AnttiLukats/DIPSY/THP2015/hw/DIPSY/readme.txt

\pcb - current last revision

\REV01\ original DIPSY easyPCB design
