AnttiLukats/DIPSY/THP2015/examples/verilog/spi_peripherals/readme.txt

place all verilog based project that works as SPI Slave here
