AnttiLukats/DIPSY/THP2015/hw/EDA/eagle/readme.txt

dipsy.lbr
- is not really tested yet
- dipsy footprint with all connections
- dipsy BB (breadboard) footprint with outer pins only
