AnttiLukats/DIPSY/THP2015/examples/verilog/ws2812b_standalone/ws2812b_single_fixed/README.md

## WS2812B standalone, single pixel, fixed color
Demonstrates the WS2812B driver. The code sends pulses for a single pixel/LED, with color fixed white at 25% (0x404040).
