AnttiLukats/DIPSY/docs/index.rst

DIPSY
=====

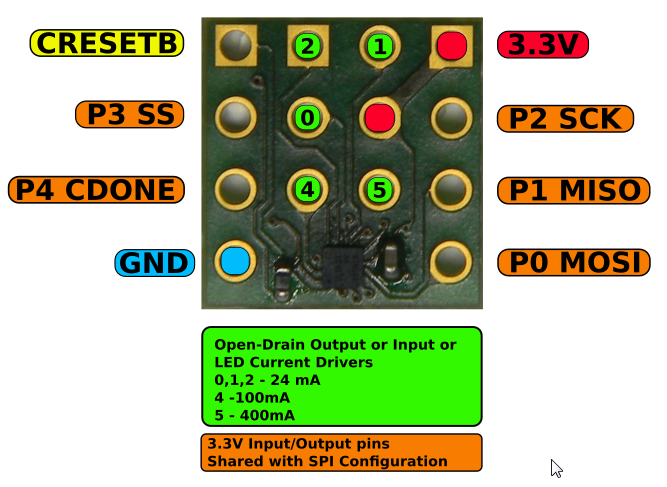
[picture p1: docs/dipsy-pinout.png]
