AnttiLukats/DIPSY/THP2015/hw/DIPSY/pcb/manufacturing reports/ExportSTEP/DIPSY-02.step

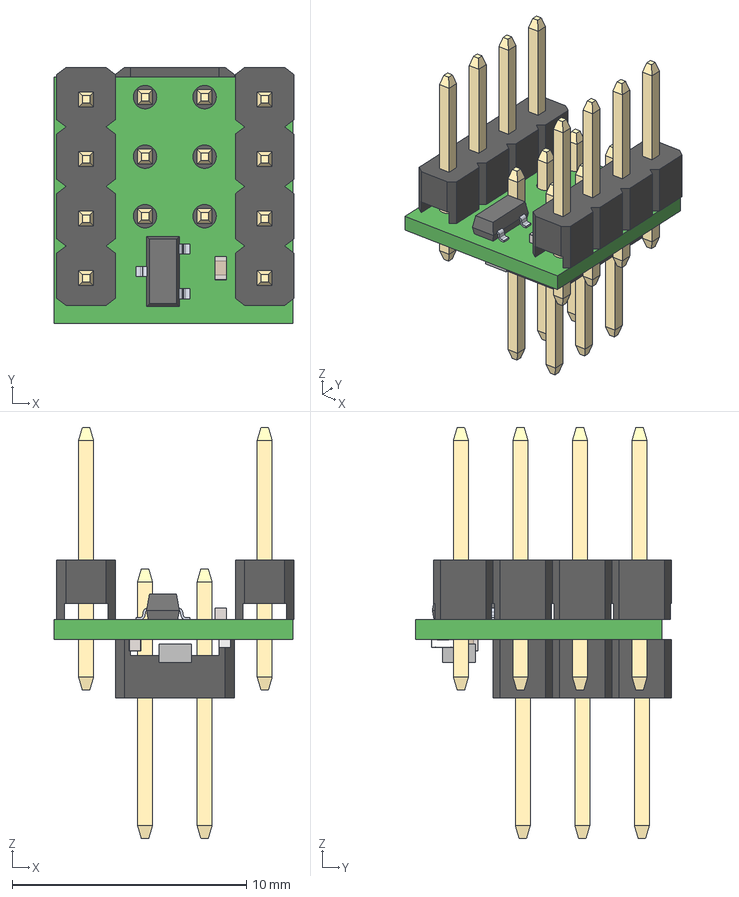
[picture p2: CAD file, 2015-09-20]
THP2015/hw/DIPSY/pcb/manufacturing reports/ExportSTEP/DIPSY-02.step
10.2 x 10.9 x 17.5 mm
Board
pin_header_awl254-dg-g06d
Extruded
pin_header_aw140-eg-g04d x 2
User_Library-SMD_CAPACITOR0402 x 2
RESC1005X04N
SOT-23_Plastic_surface-mounted_package;_3_leads;_3.0x2.5_mm
