AnttiLukats/DIPSY/(list of files, cad)

Other CAD files:
THP2015/hw/DIPSY/REV01/manufacturing reports/ExportSTEP/DIPSY-01.step
