AnttiLukats/DIPSY/THP2015/hw/EDA/CircuitMaker/readme.txt

Repo for CiruitMaker related files and infos

Note: Circuit maker stores the projects in cloud and not locally so here only some export file an links can be stored
