AnttiLukats/DIPSY/THP2015/DIPSY-GUIDE/graphics/svg/readme.txt

Please use free InkScape to modify the SVG Graphics
