AnttiLukats/DIPSY/THP2015/DIPSY-GUIDE/graphics/images/DIPSY_PCB_TOP.JPG

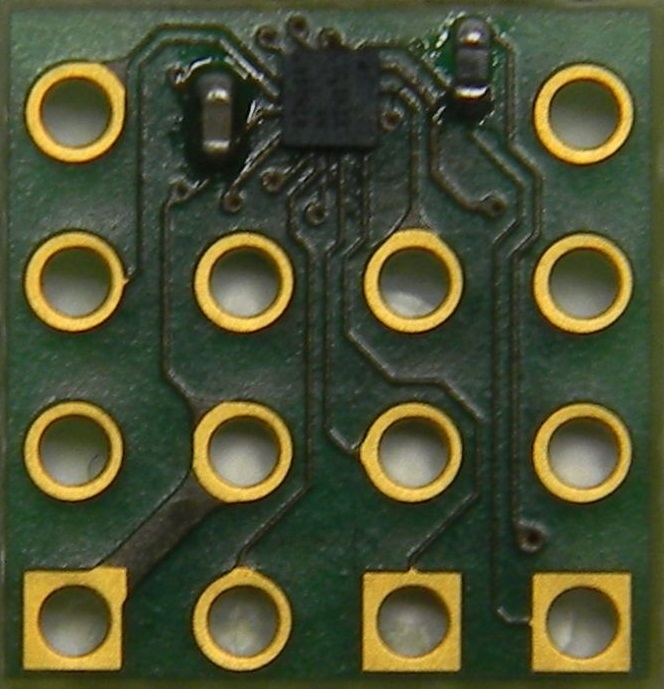
THP2015/DIPSY-GUIDE/graphics/images/DIPSY_PCB_TOP.JPG
