AnttiLukats/DIPSY/(threads)

Thread 2 (2015-08-28):

Possible application: SPI or I2C -> dipsy -> Shift registers -> Servos

crteensy, 2015-08-28:
Use a dipsy to generate PPM signals, feed them into shift registers and drive servos:

I2C: 2 I/O, SPI: 3 I/O (I2C is probably cool because the data rate for servos is low)
- 8 servos per reg
- one shared "data" pin for all registers
- one clock for each shift register
- leaves us with (10-2-1) = 7 clock outputs = 56 servos with I2C
or (10-3-1) = 6 clock outputs = 48 servos with SPI

Thread 3 (2015-08-28):

Possible application: monochrome -> RGB565 pixel expander

crteensy, 2015-08-28:
(this is what I actually want to do with the dipsy)

I have an application where my graphical data is monochrome, but my display has 16-bit color depth. Drawing is done on a monochrome frame buffer (128*128 pixels) in a teensy 3.1. Without any external hardware I then need to expand each pixel to 16 bits, in "chunks", and send those to the display. This wastes CPU and SPI time. Monochrome to RGB565 expansion can instead be done by a dipsy.

- MCU -> SPI -> Dipsy
- 2 kB frame buffer
- Dipsy -> SPI -> Display
- one slave select each for dipsy config (foreground color), direct display access (init and stuff like that), and framebuffer access
