AnttiLukats/DIPSY/THP2015/hw/DIPSY-EPT/pcb/manufacturing reports/PDF/SCH-TE0888-02.PDF

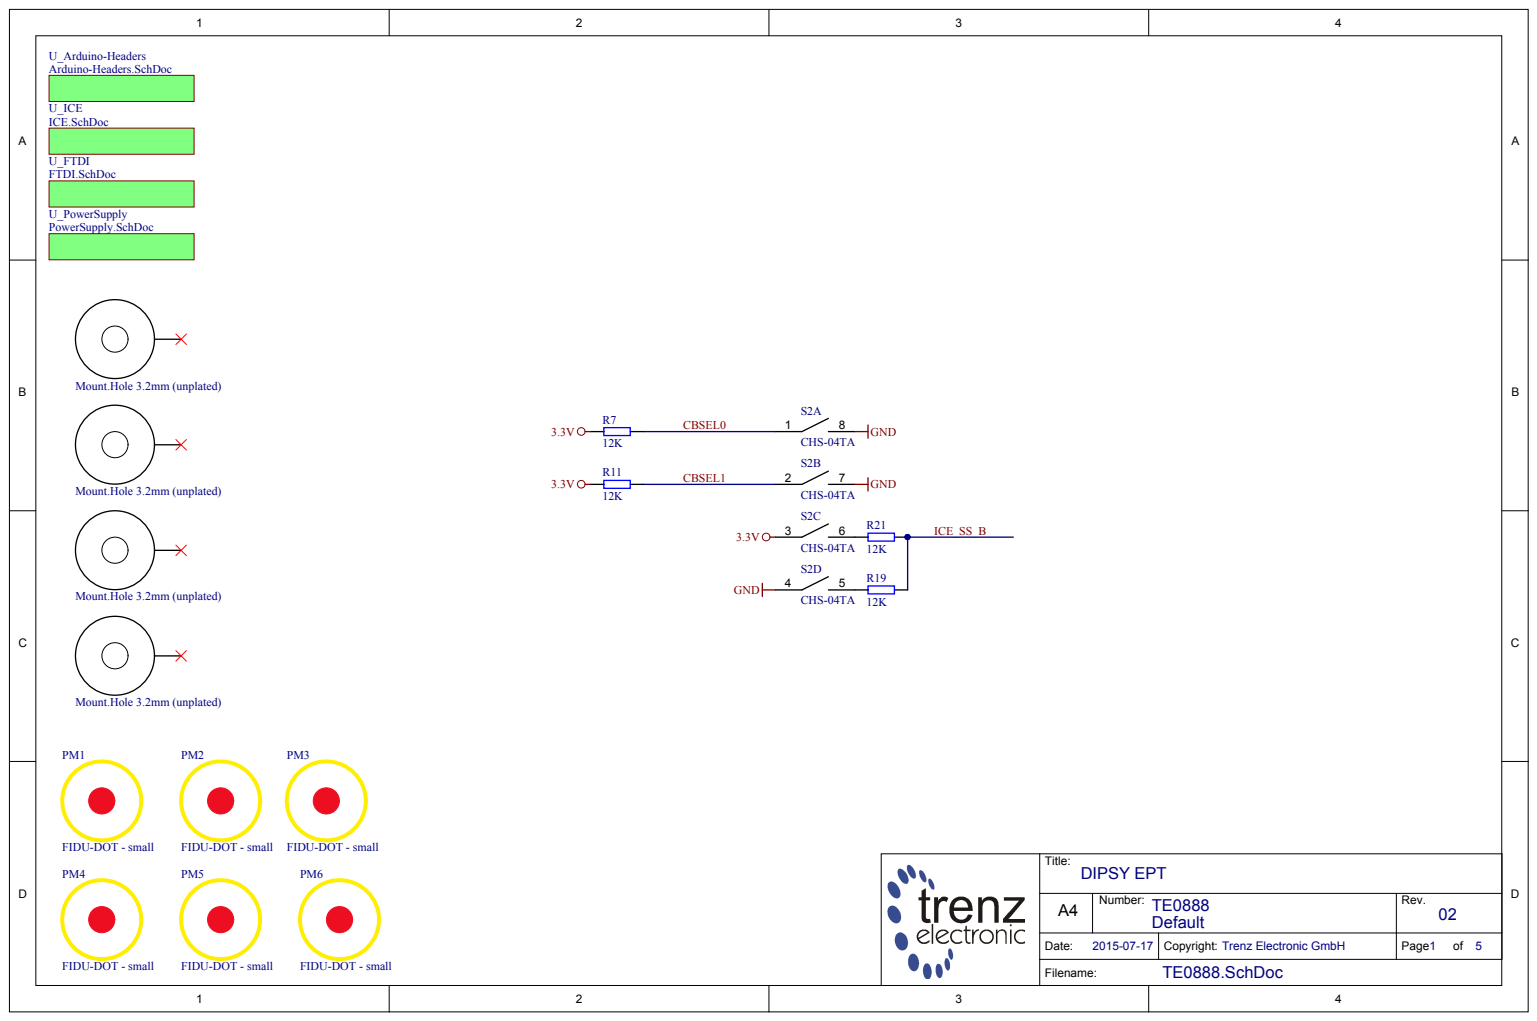
[picture p4: page 1]

Title: DIPSY EPT

A4 | Number: TE0888 Default | Rev. 02

Date: 2015-07-17 | Copyright: Trenz Electronic GmbH | Page1 of 5

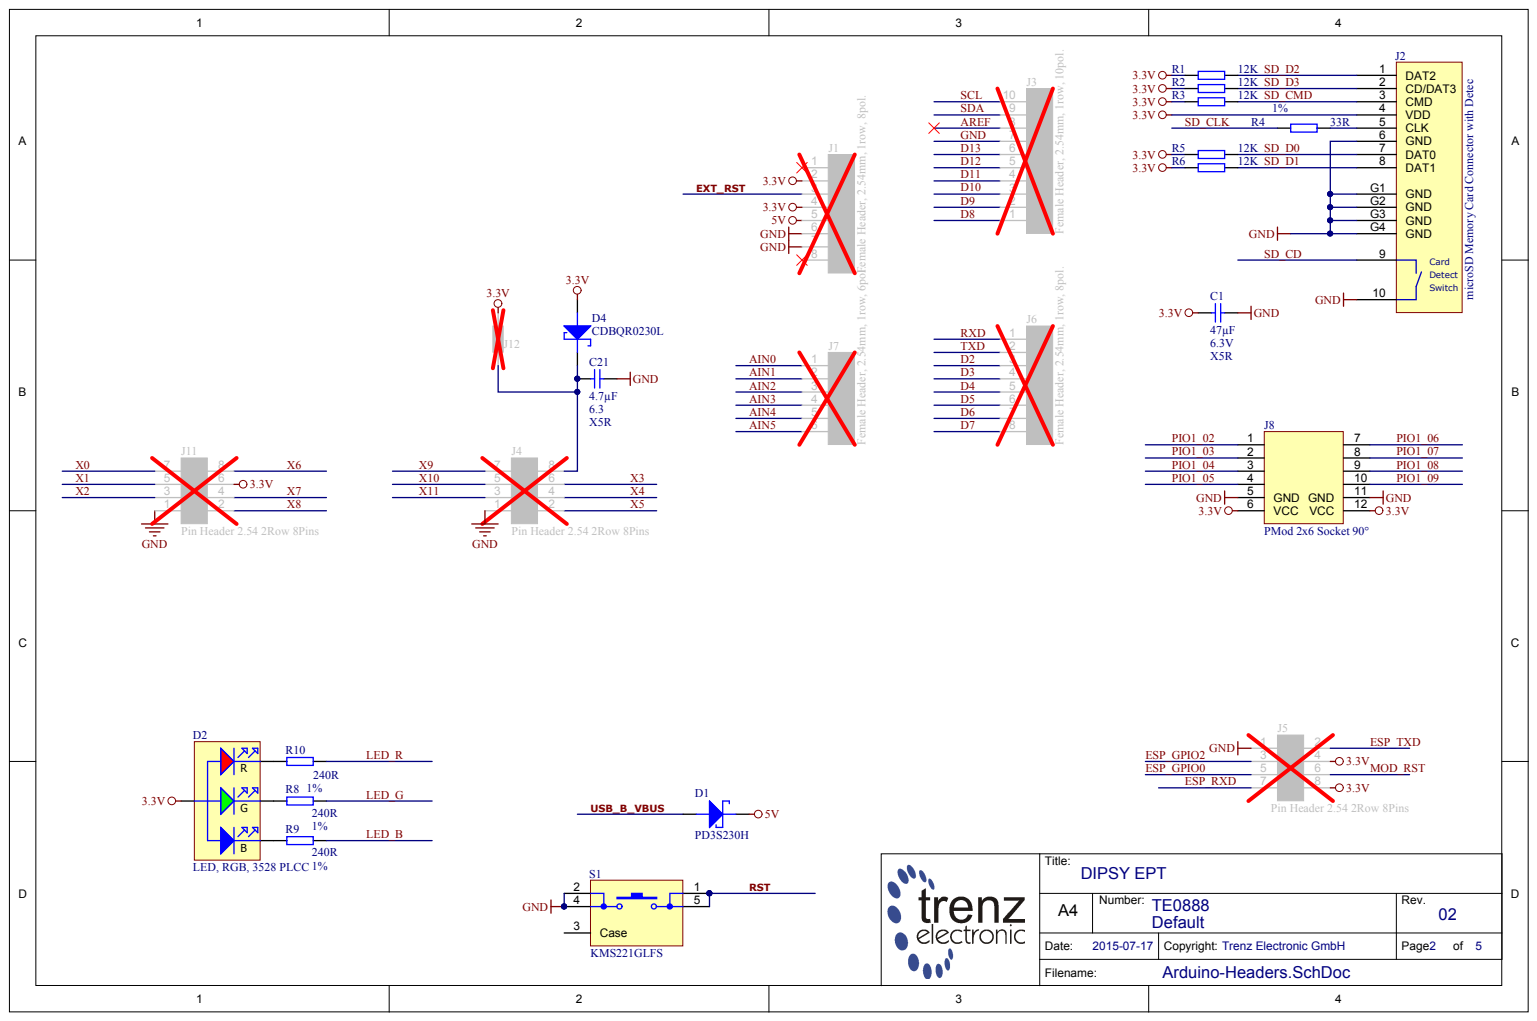
[picture p5: page 2]

microSD Memory Card Connector with Detec

DAT0 7
DAT1 8

GND G1
GND G2
GND G3

Copyright: Trenz Electronic GmbH

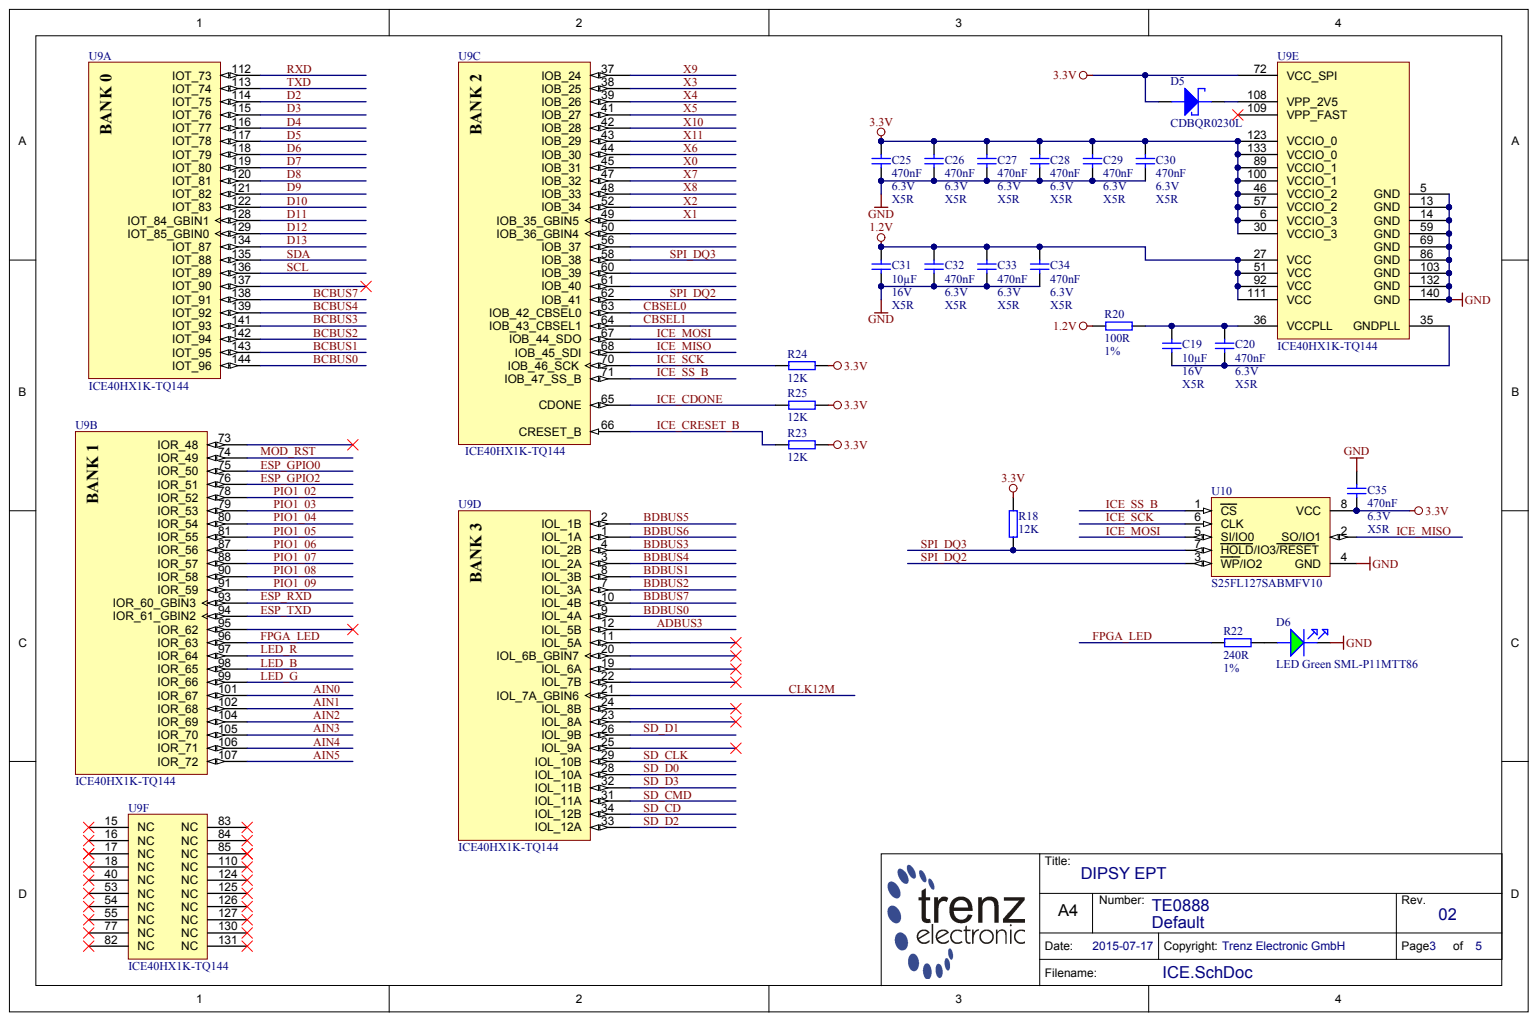
[picture p6: page 3]

Copyright: Trenz Electronic GmbH

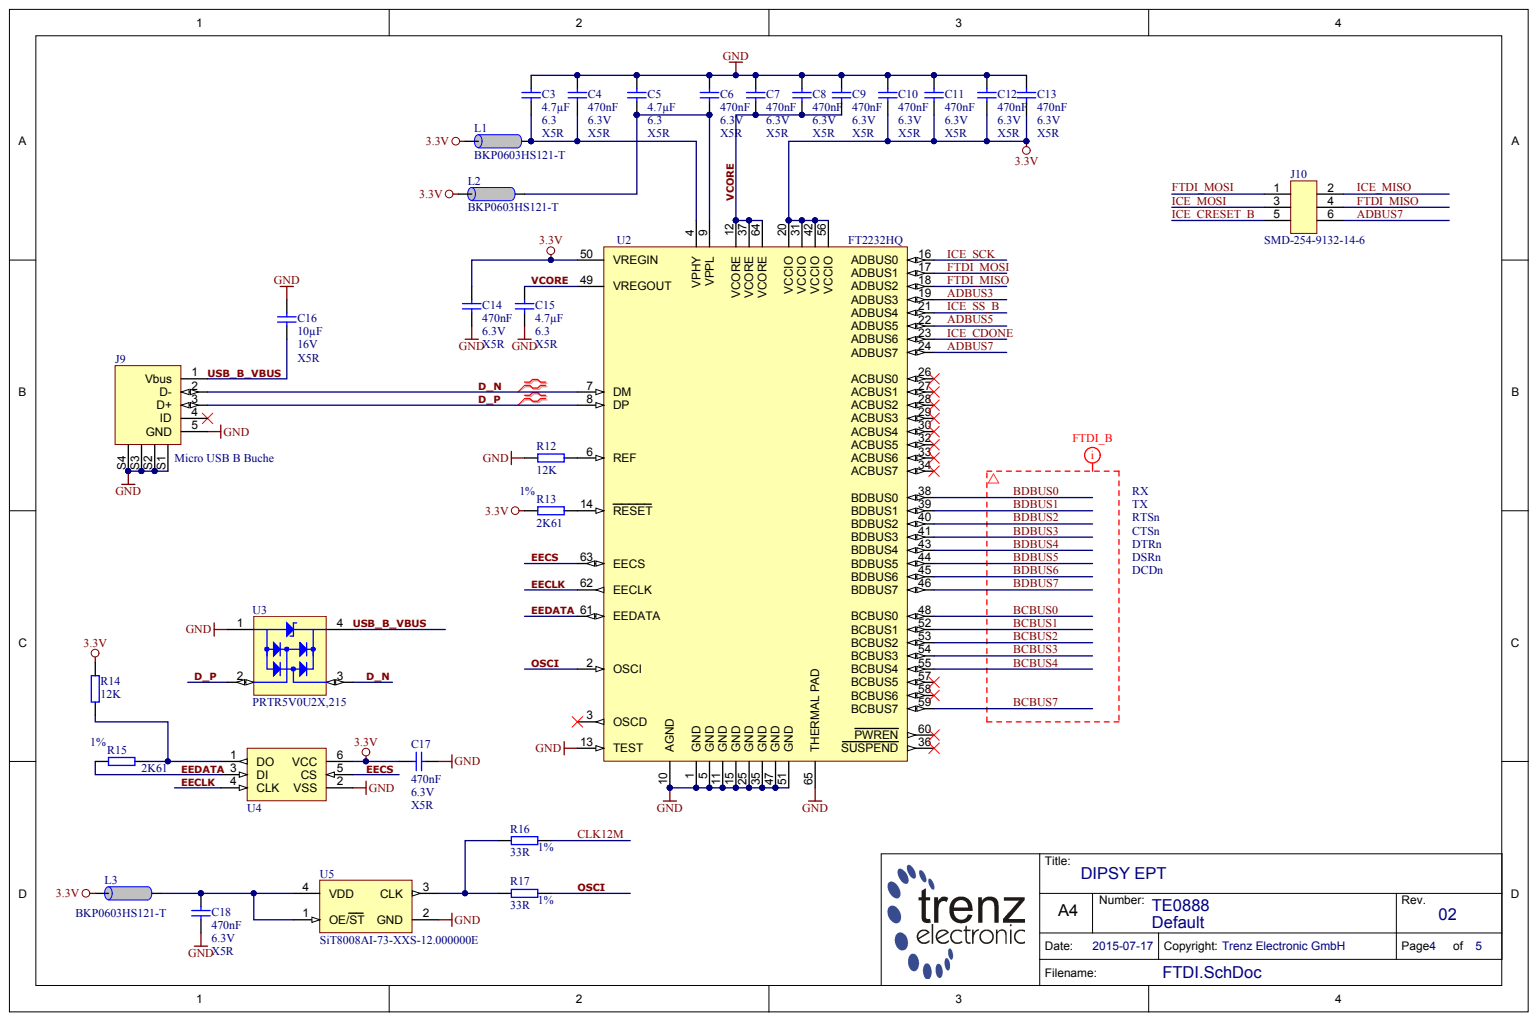
[picture p7: page 4]

REF 6

EECS 63 | BDBUS2

Title: DIPSY EPT

A4 | Number: TE0888 Default | Rev. 02

Date: 2015-07-17 | Copyright: Trenz Electronic GmbH | Page4 of 5

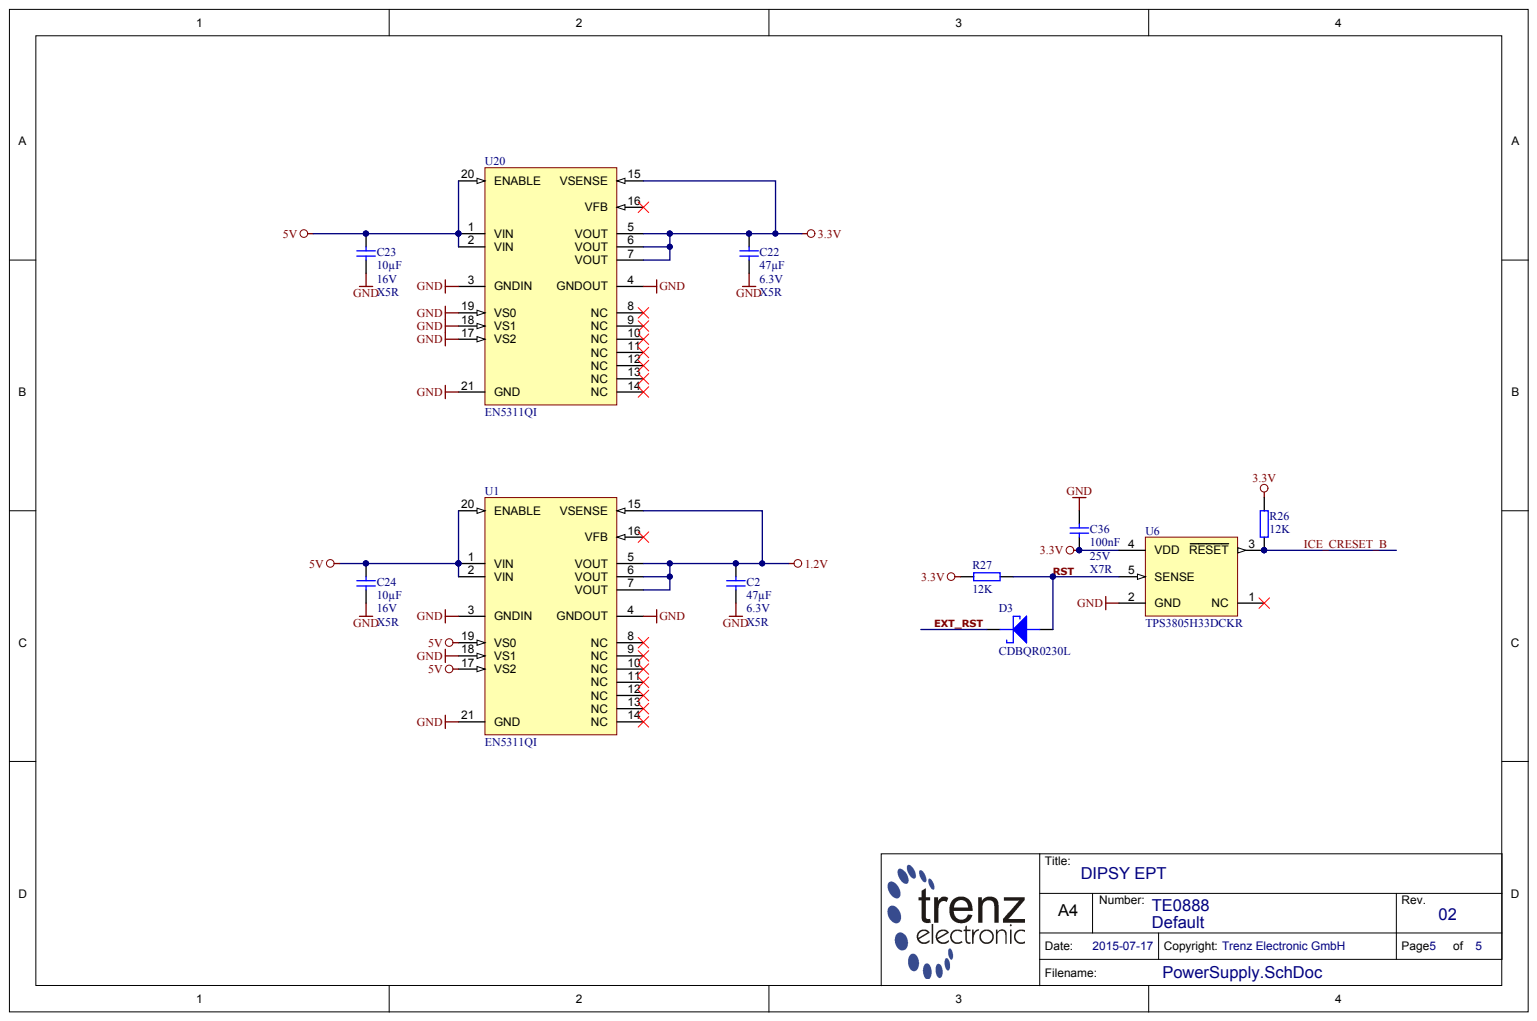
[picture p8: page 5]

Title: DIPSY EPT

A4 | Number: TE0888 Default | Rev. 02

Date: 2015-07-17 | Copyright: Trenz Electronic GmbH | Page5 of 5
