AnttiLukats/DIPSY/THP2015/hw/DIPSY/pcb/manufacturing reports/PDF/SCH-DIPSY-02.PDF

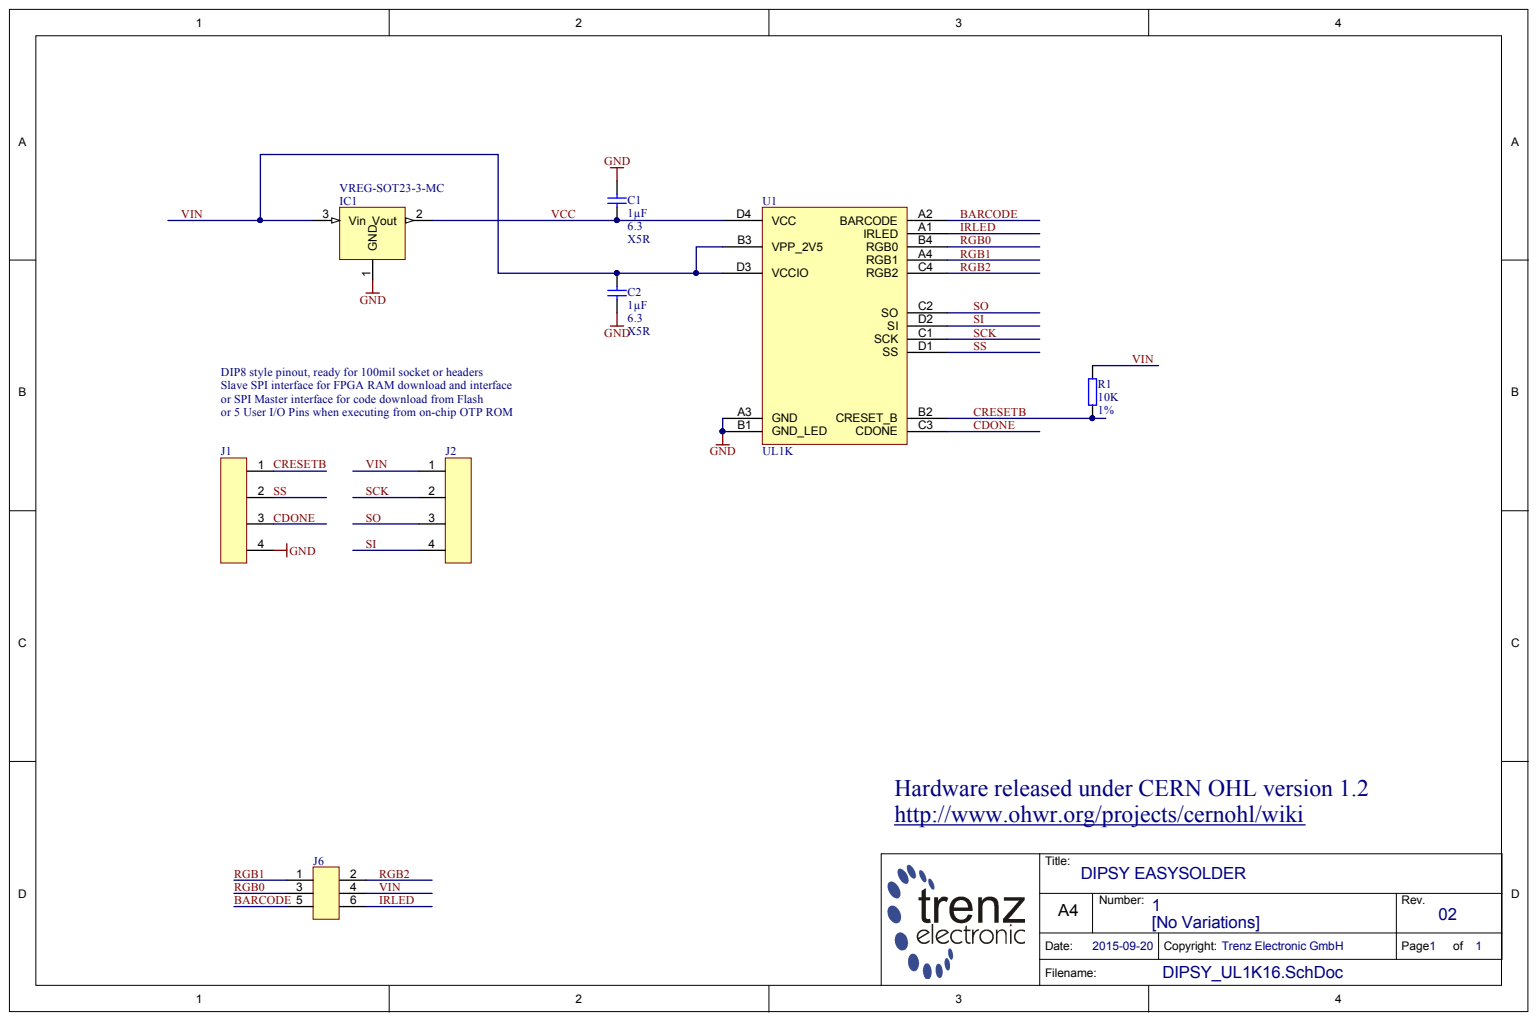
[picture p9: page 1]

6.3 X5R | VPP_2V5 B3

VCCIO D3

DIP8 style pinout, ready for 100mil socket or headers
Slave SPI interface for FPGA RAM download and interface
or SPI Master interface for code download from Flash
or 5 User I/O Pins when executing from on-chip OTP ROM

Hardware released under CERN OHL version 1.2
http://www.ohwr.org/projects/cernohl/wiki

Title: DIPSY EASYSOLDER

A4 | Number: 1 [No Variations] | Rev. 02

Date: 2015-09-20 | Copyright: Trenz Electronic GmbH | Page1 of 1
