AnttiLukats/DIPSY/THP2015/hw/DIPSY-EPT/pcb/manufacturing reports/PDF/3DB-TE0888-02.PDF

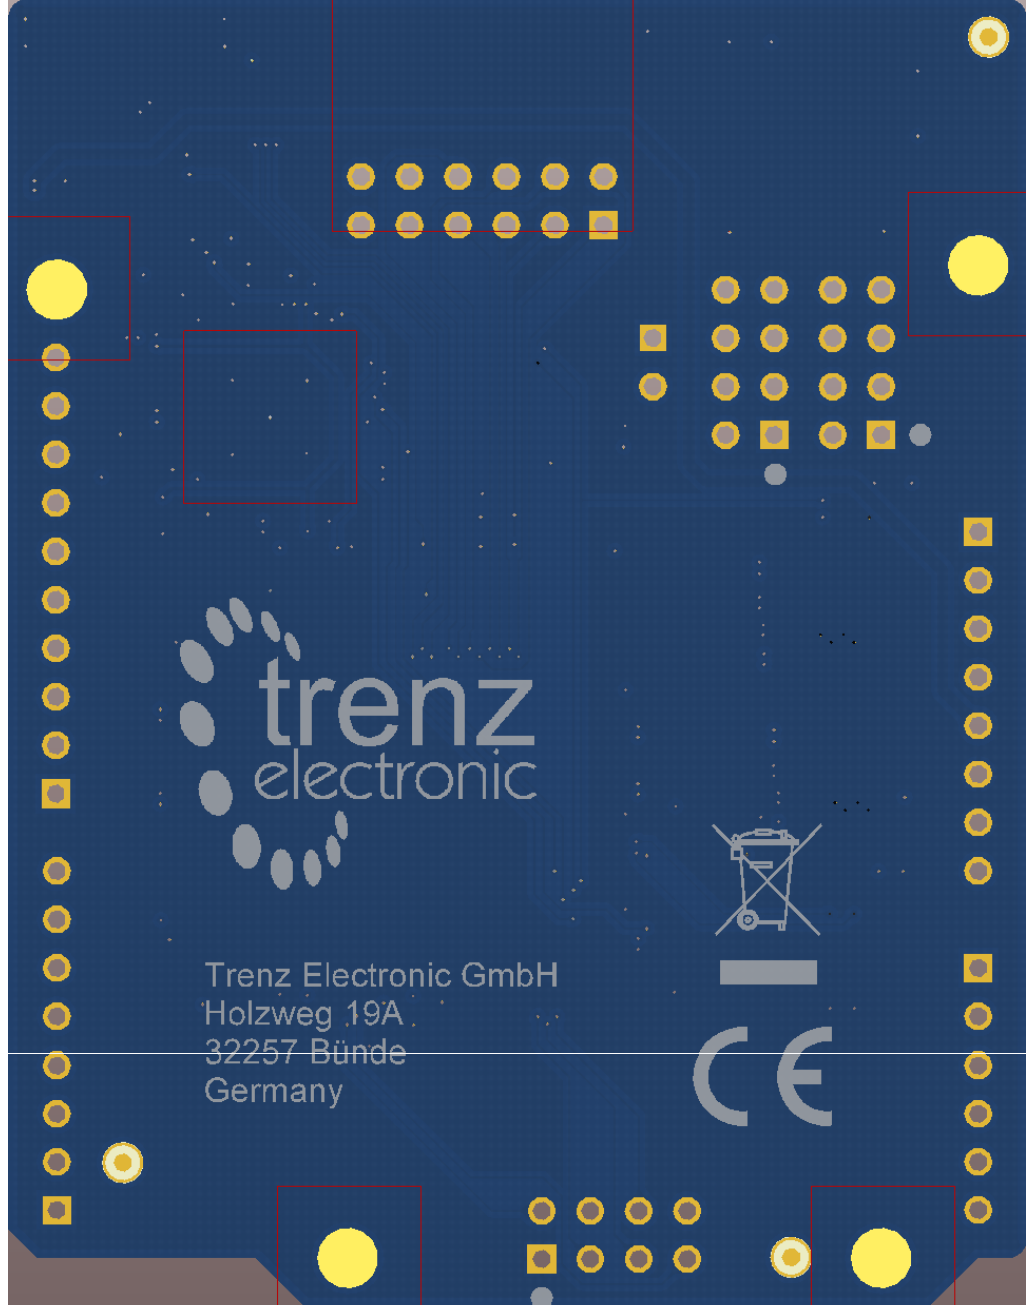
[picture p10: page 1]
