AnttiLukats/DIPSY/THP2015/hw/DIPSY-EPT/pcb/manufacturing reports/PDF/3DT-TE0888-02.PDF

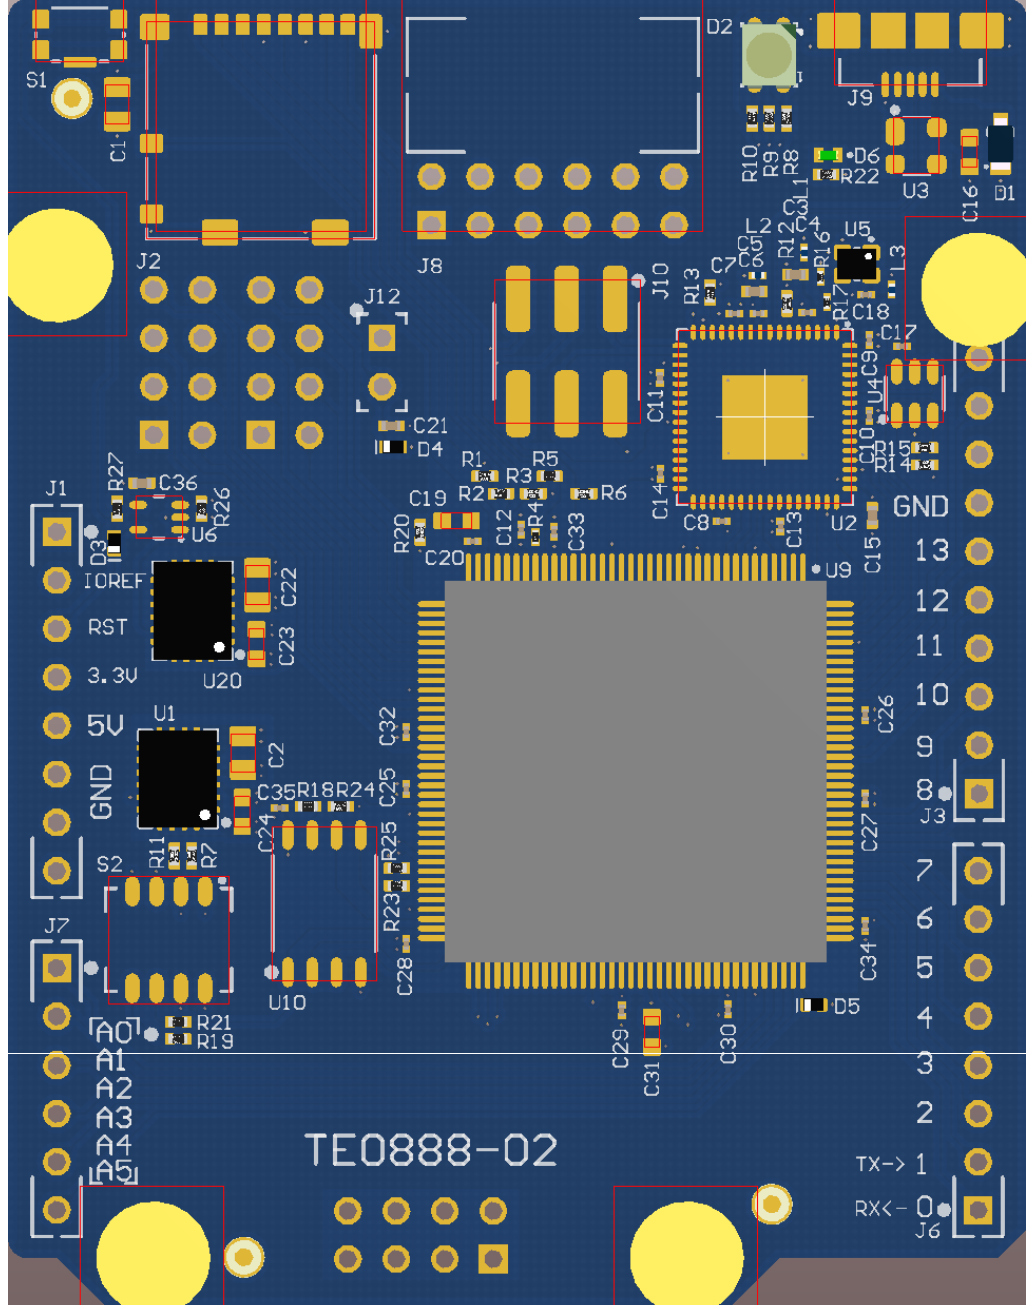
[picture p11: page 1]
