AnttiLukats/DIPSY/THP2015/hw/DIPSY-EPT/pcb/manufacturing reports/PDF/AD-TE0888-02.PDF

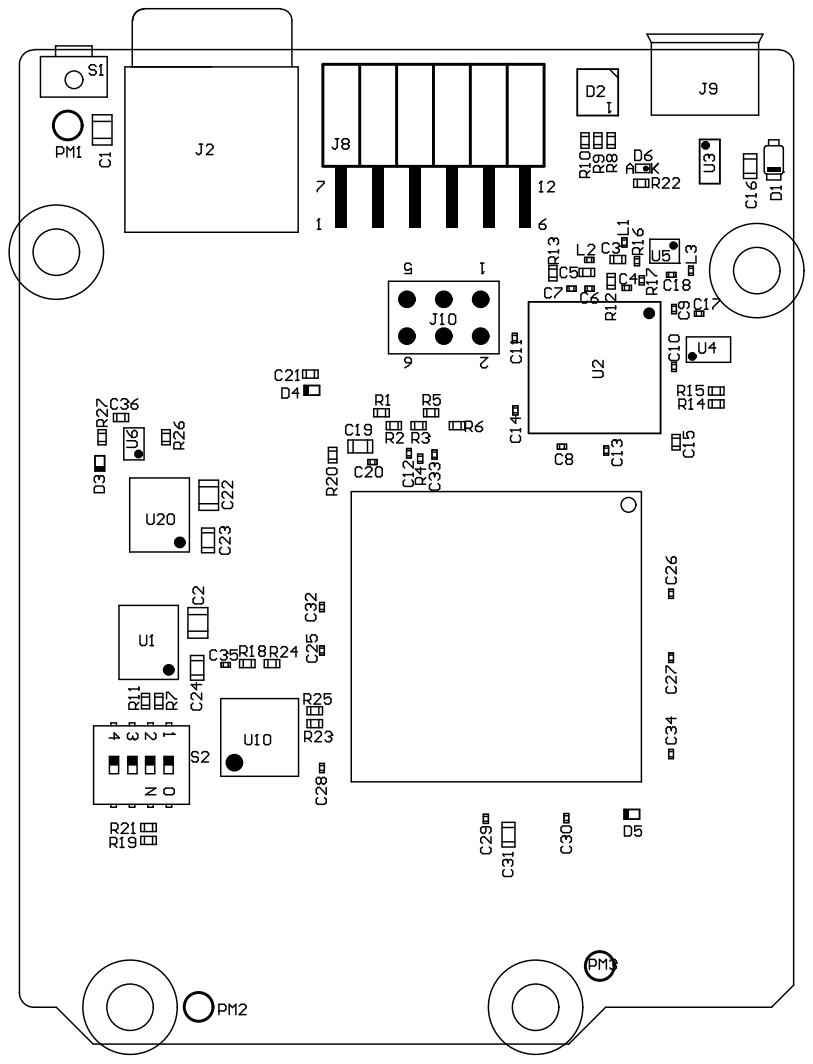
[picture p12: page 1]

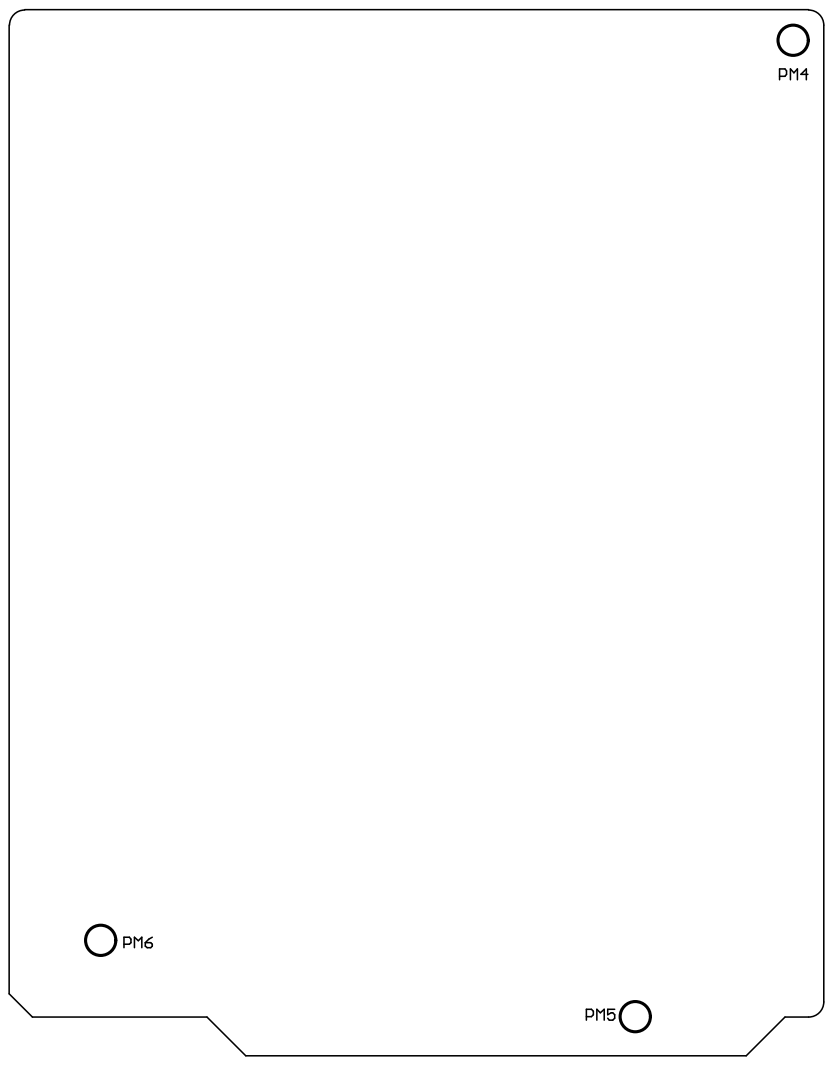
[picture p13: page 2]

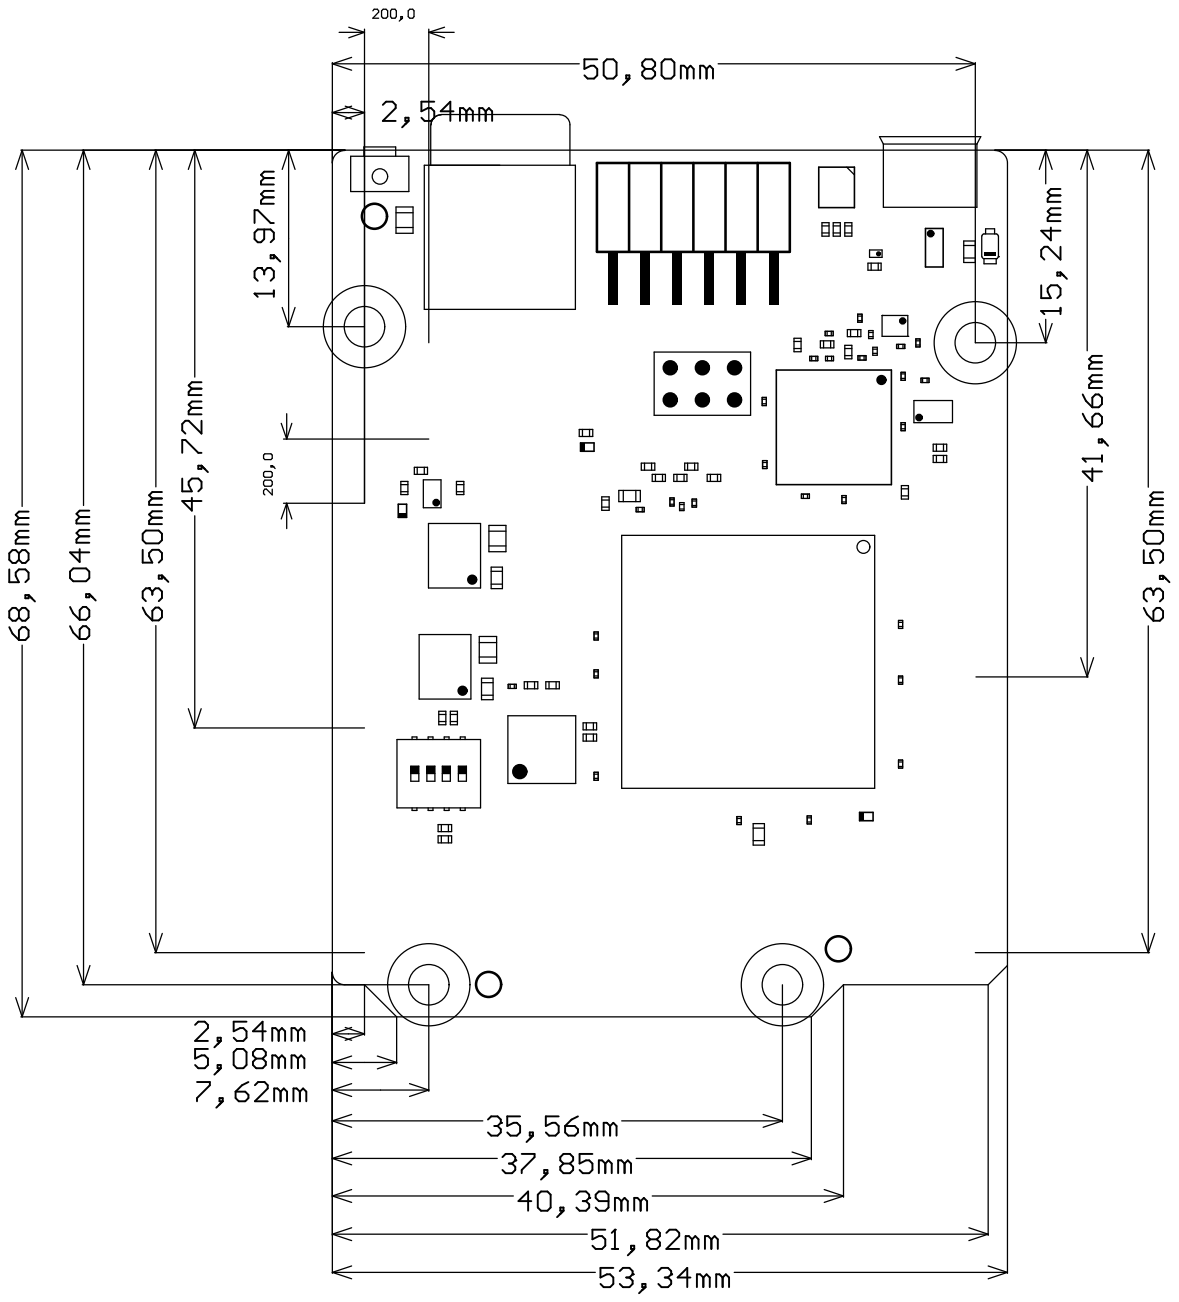
[picture p14: page 3]

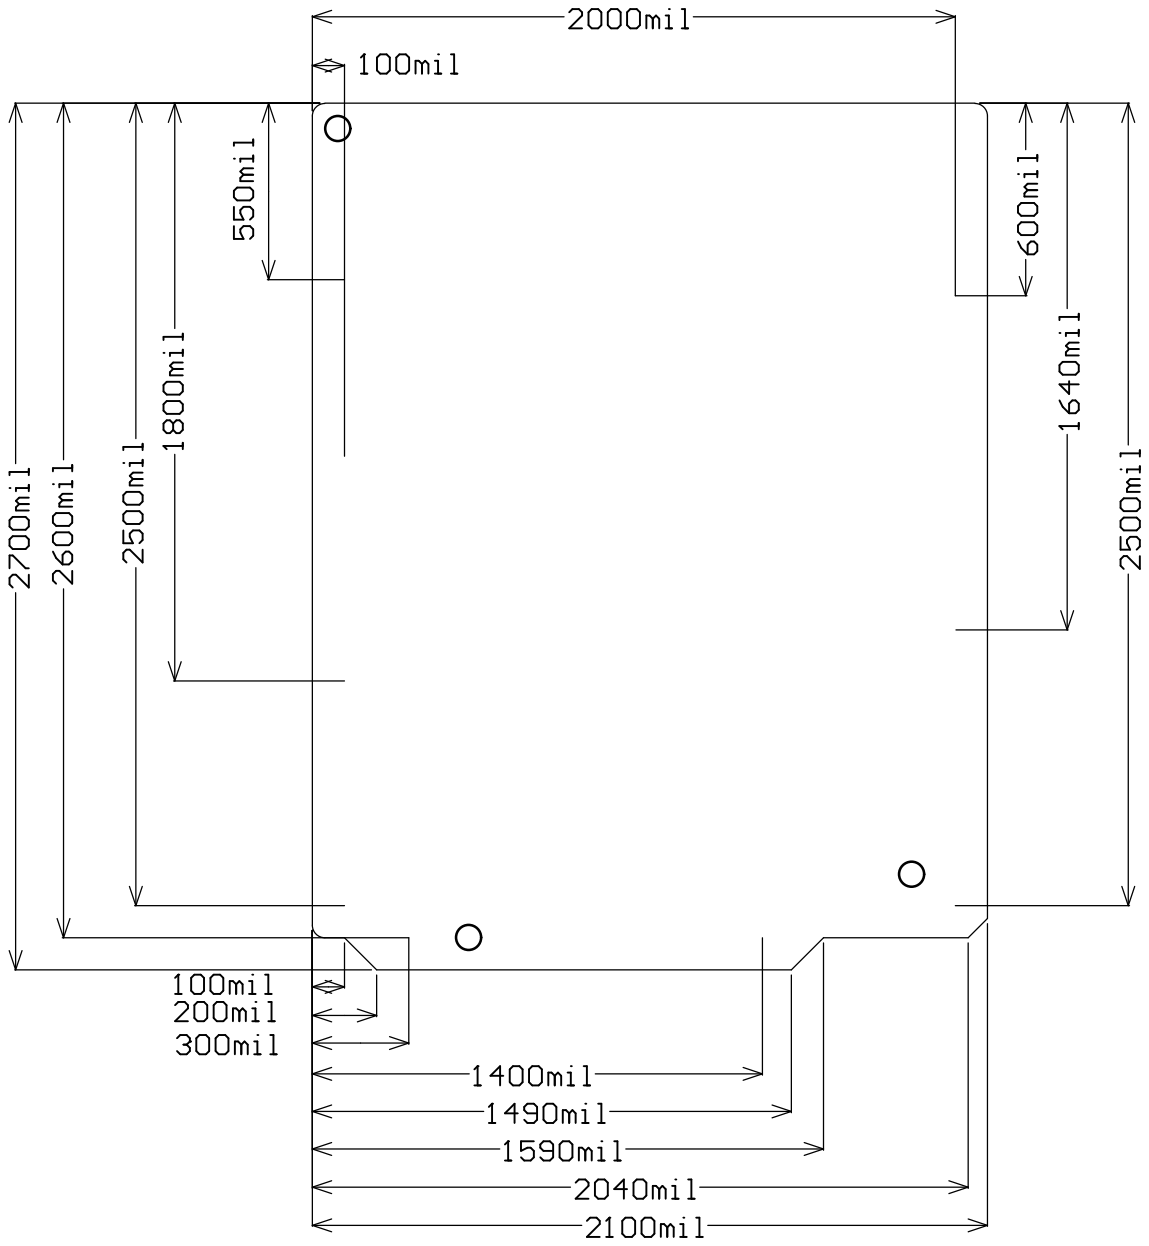
[picture p15: page 4]
