AnttiLukats/DIPSY/THP2015/hw/DIPSY/pcb/manufacturing reports/PDF/3DB-DIPSY-02.PDF

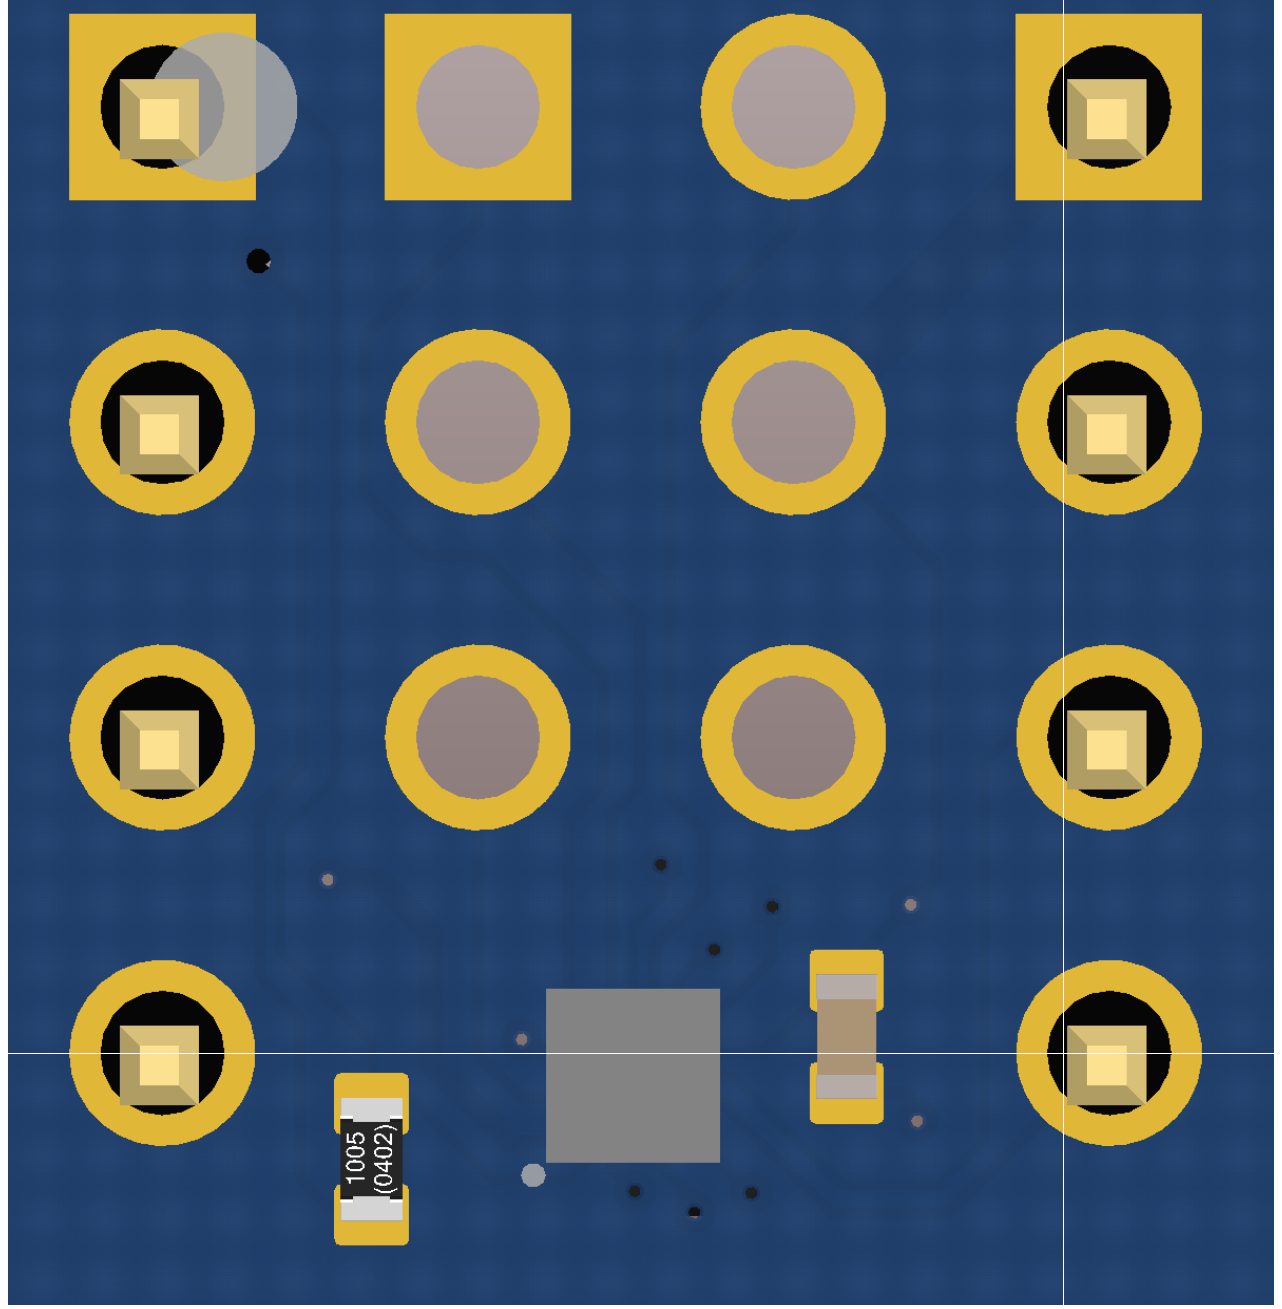
[picture p16: page 1]
