AnttiLukats/DIPSY/THP2015/hw/DIPSY/pcb/manufacturing reports/PDF/3DT-DIPSY-02.PDF

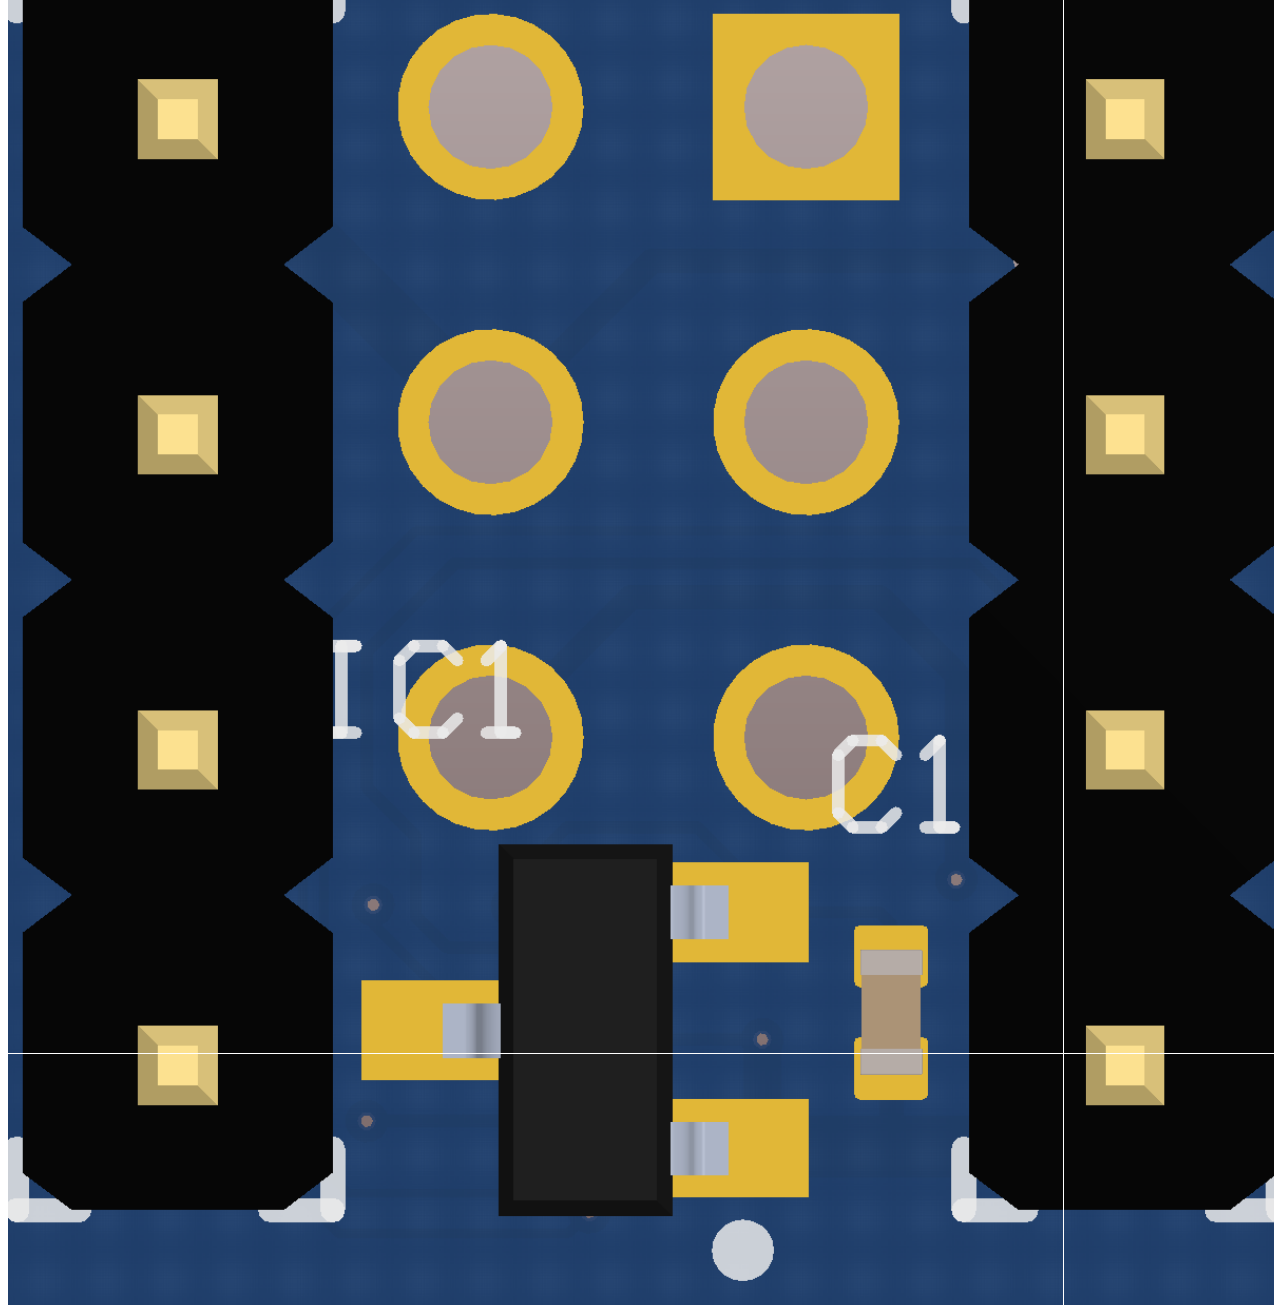
[picture p17: page 1]
