AnttiLukats/DIPSY/THP2015/hw/DIPSY/REV01/manufacturing reports/PDF/3DB-DIPSY-01.PDF

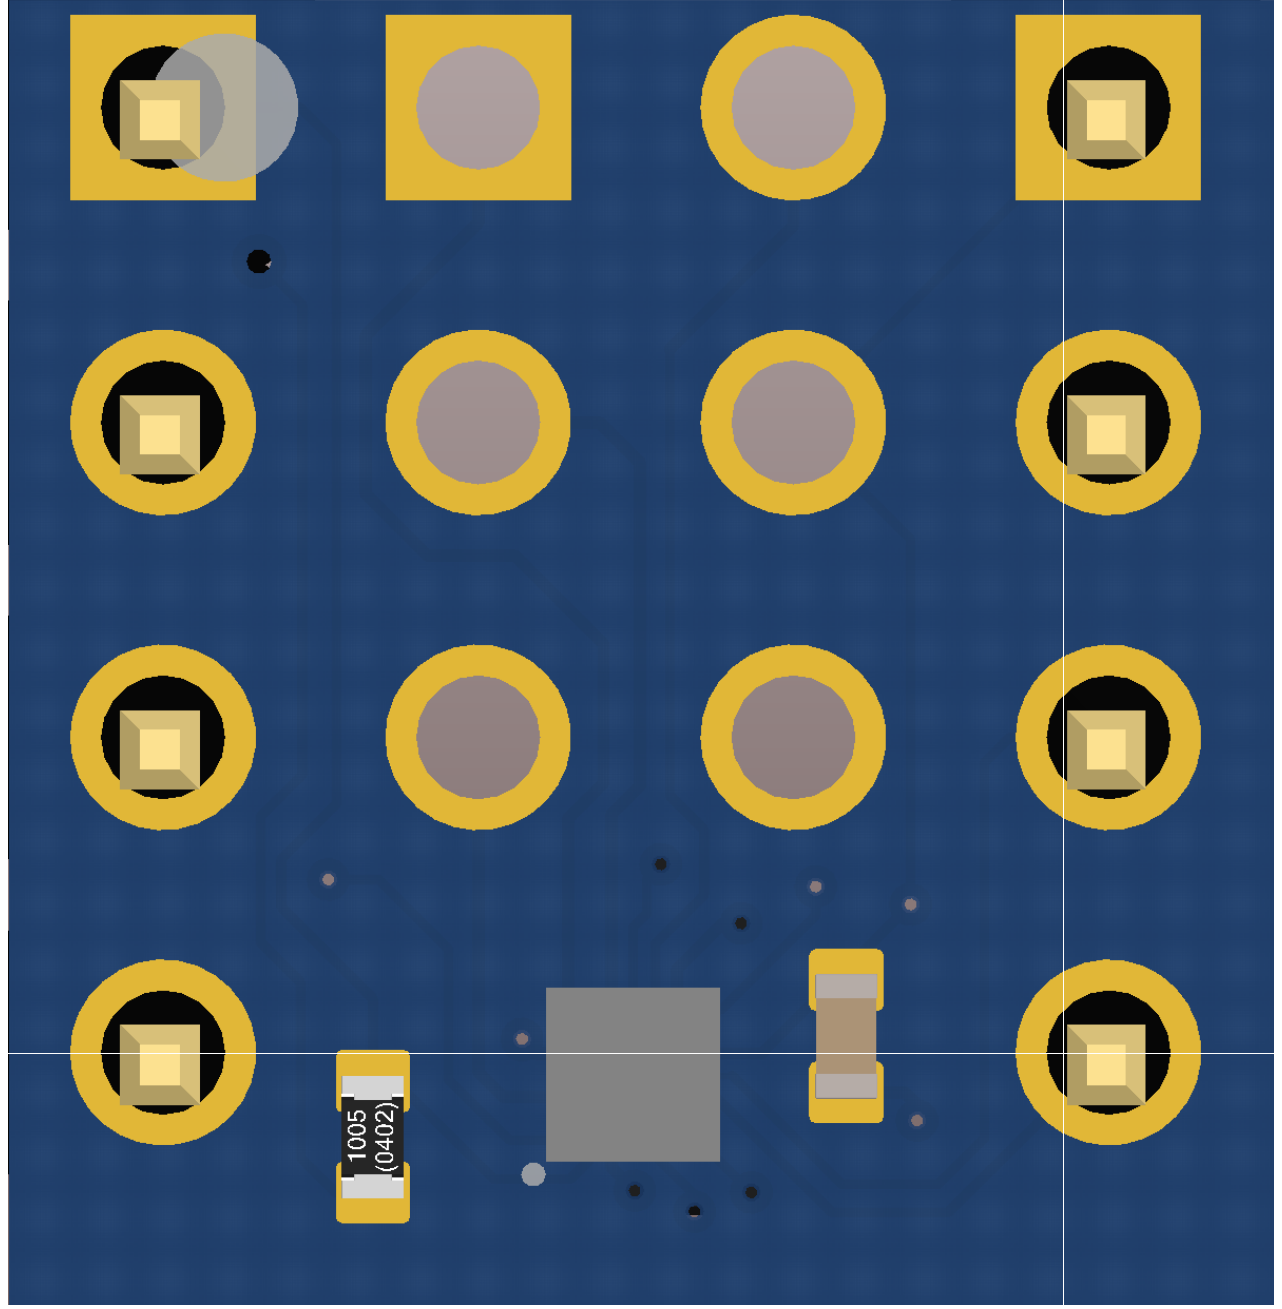
[picture p22: page 1]
