AnttiLukats/DIPSY/THP2015/hw/DIPSY/REV01/manufacturing reports/PDF/3DT-DIPSY-01.PDF

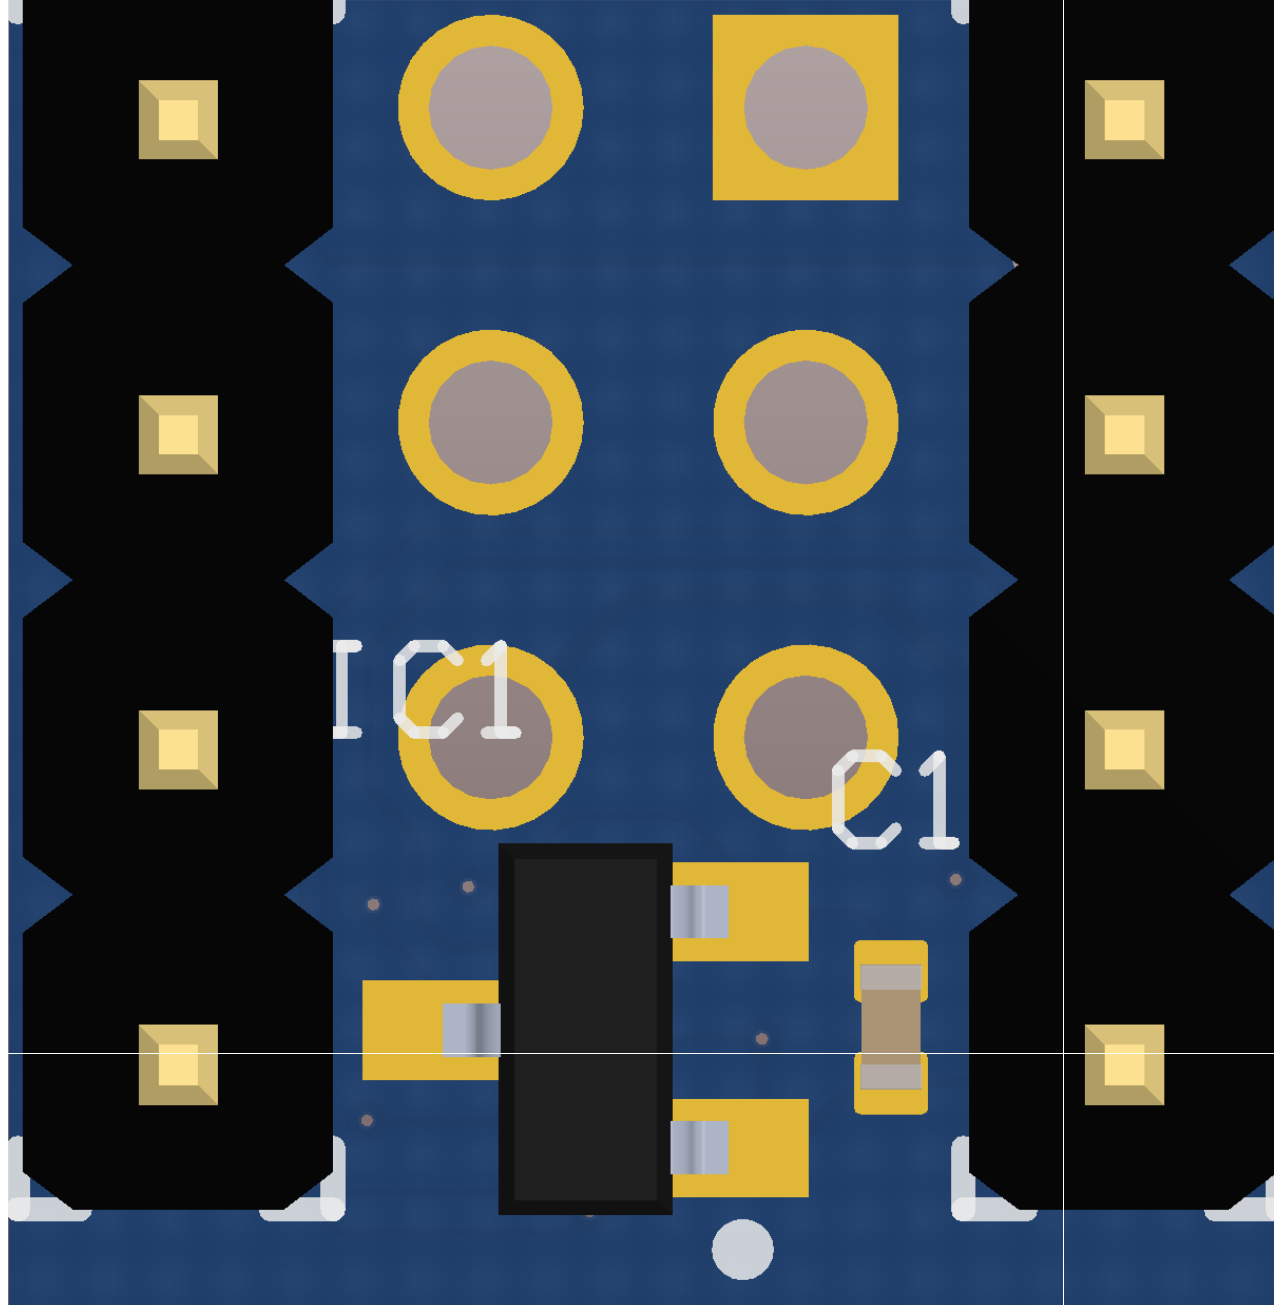
[picture p23: page 1]
