AnttiLukats/DIPSY/THP2015/hw/DIPSY/REV01/manufacturing reports/PDF/AD-DIPSY-01.PDF

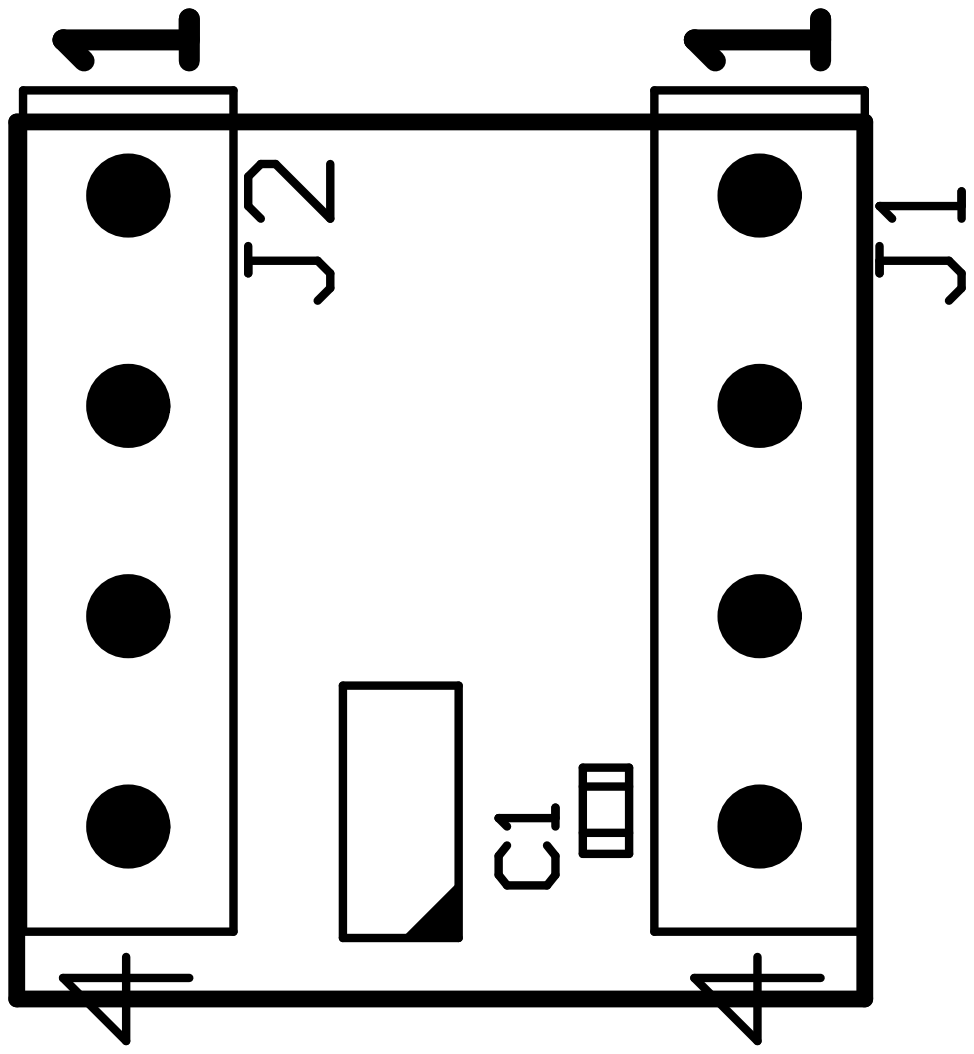
[picture p24: page 1]

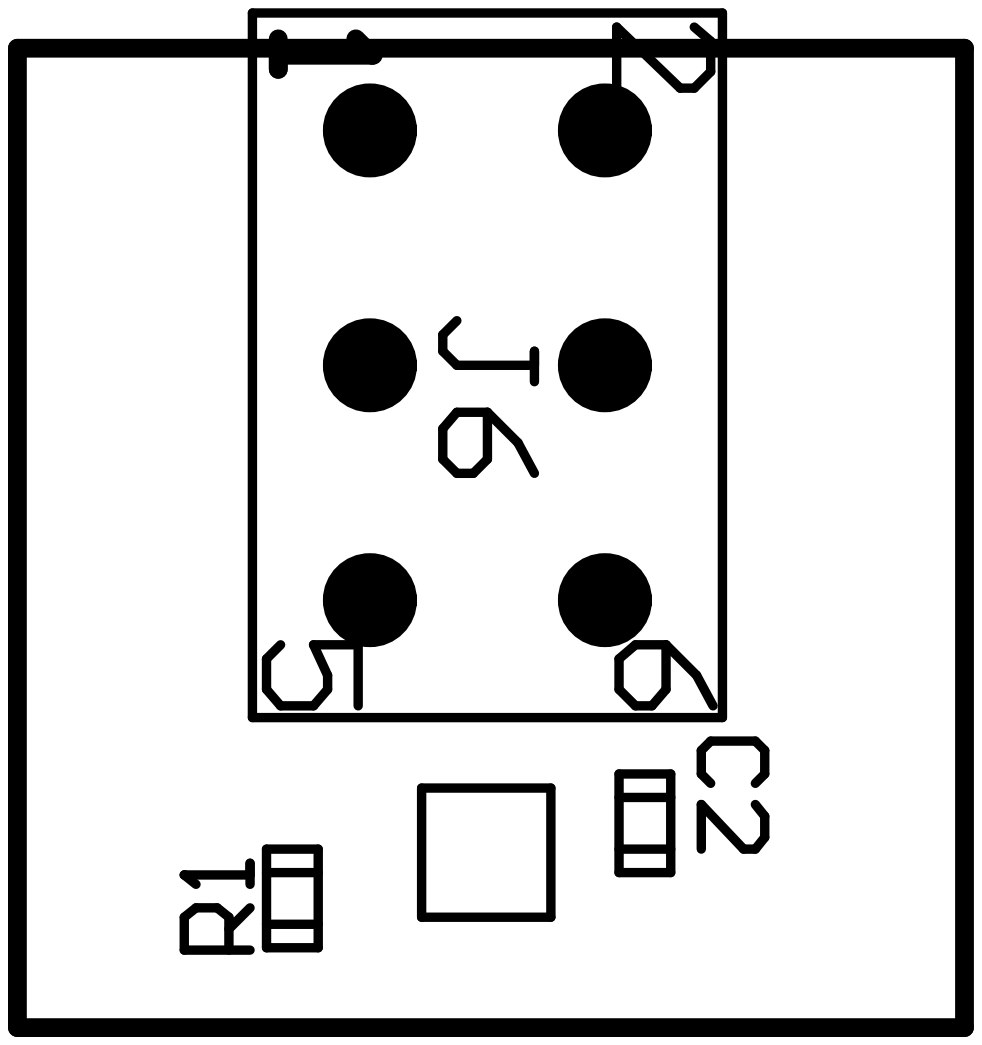
[picture p25: page 2]

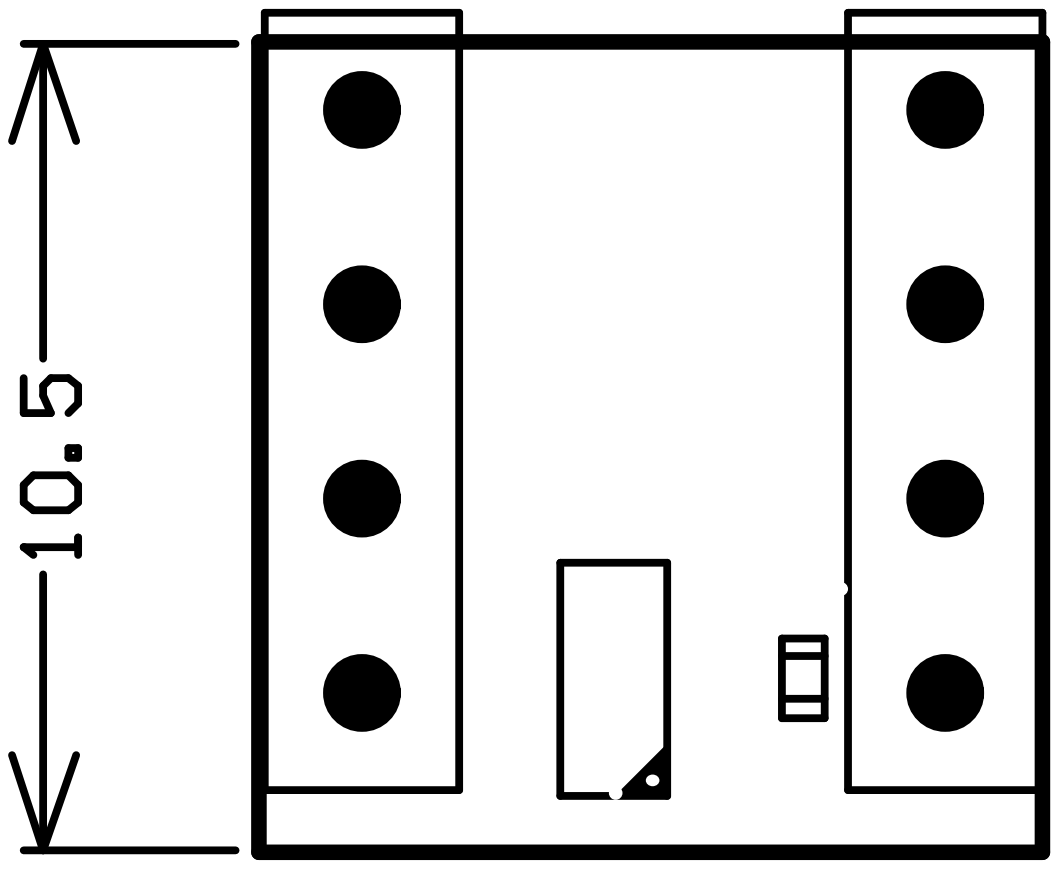
[picture p26: page 3]

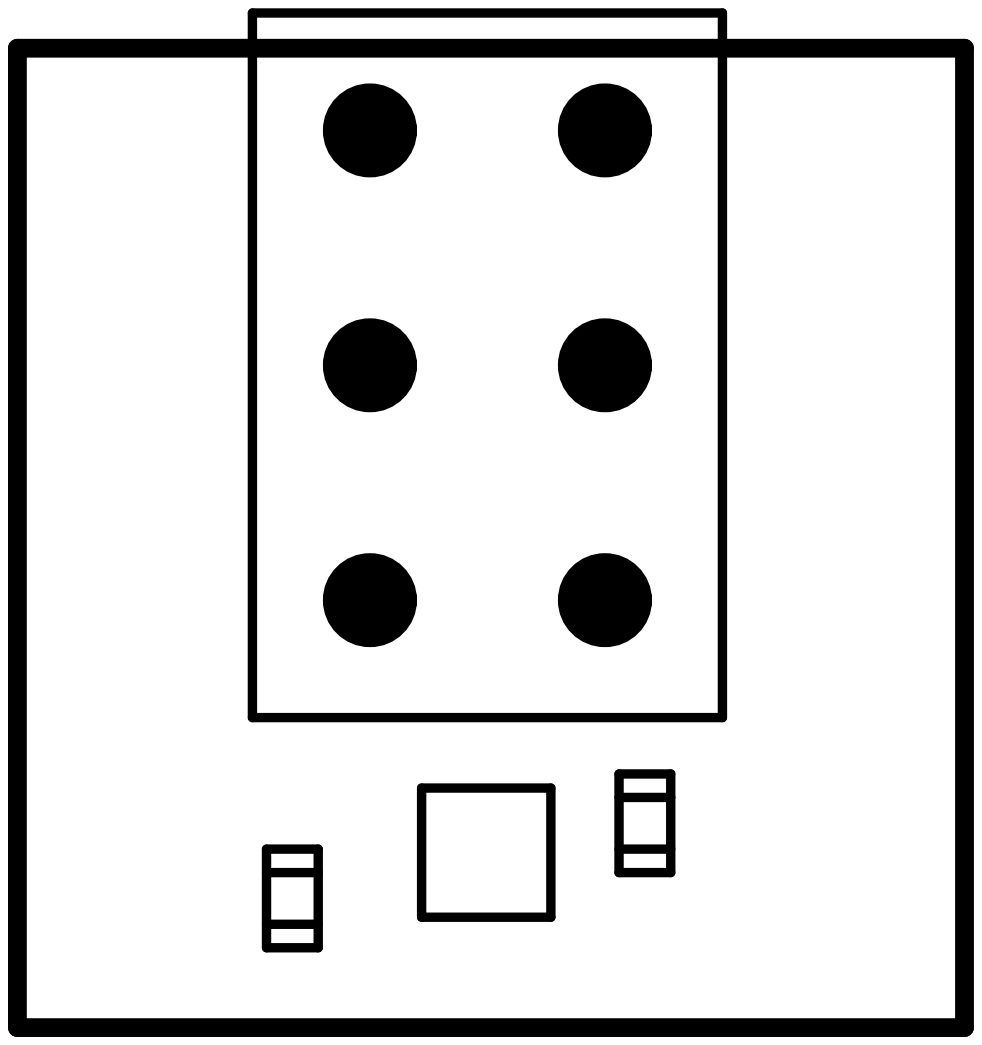
[picture p27: page 4]
