AnttiLukats/DIPSY/(list of files, drawings)

Other design files:
THP2015/hw/DIPSY-EPT/pcb/Arduino-Headers.SchDoc
THP2015/hw/DIPSY-EPT/pcb/FTDI.SchDoc
THP2015/hw/DIPSY-EPT/pcb/ICE.SchDoc
THP2015/hw/DIPSY-EPT/pcb/PowerSupply.SchDoc
THP2015/hw/DIPSY-EPT/pcb/TE0888.PrjPCB
THP2015/hw/DIPSY-EPT/pcb/TE0888.SchDoc
THP2015/hw/DIPSY-LED5/pcb/DIPSY_UL1K16_LED5.PcbDoc
THP2015/hw/DIPSY-LED5/pcb/DIPSY_UL1K16_LED5.PrjPCB
THP2015/hw/DIPSY-LED5/pcb/DIPSY_UL1K16_LED5.SchDoc
THP2015/hw/DIPSY-PL2812/PL2812B.PcbDoc
THP2015/hw/DIPSY-PL2812/PL2812B.PrjPCB
THP2015/hw/DIPSY-PL2812/PL2812B.SchDoc
THP2015/hw/DIPSY-STARTER/pcb/TE7300.PcbDoc
THP2015/hw/DIPSY-STARTER/pcb/TE7300.PrjPCB
THP2015/hw/DIPSY-STARTER/pcb/TE7300.SchDoc
THP2015/hw/DIPSY/pcb/DIPSY_UL1K16.PcbDoc
THP2015/hw/DIPSY/pcb/DIPSY_UL1K16.SchDoc
THP2015/hw/DIPSY/REV01/DIPSY_UL1K16.PcbDoc
THP2015/hw/DIPSY/REV01/DIPSY_UL1K16.SchDoc
THP2015/hw/DIPSY/REV01/DIPSY_UL1K16_easy.PrjPCB
THP2015/hw/EDA/fritzing/edison/DIPSY_EDISON.fzz
THP2015/hw/EDA/fritzing/galileo/DIPSY_Galileo.fzz
THP2015/hw/EDA/fritzing/propeller/DIPSY_Propeller.fzz
THP2015/hw/EDA/fritzing/RPi/DIPSY_RPi_modela.fzz
THP2015/hw/EDA/fritzing/teensy/DIPSY_CONFIG.fzz
