AnttiLukats/DIPSY/THP2015/examples/verilog/basics/01_inout/sketch/sketch.ino

#include <SPI.h>
#include <dipsydownloader.h>

extern const uint8_t inout_bin[];
extern const size_t inout_bin_size;

#define DIPSY_CRESETB 0
#define DIPSY_CDONE 1
#define DIPSY_SS 2

#define MY_PIN 14

void setup() {
  // put your setup code here, to run once:
  while(!Serial.available());
  while(Serial.available()) Serial.read();

  SPI.begin();
  dipsy::ArrayConfig dipsyConfig(inout_bin_size, inout_bin);
  Serial.print("configuring dipsy...");
  if(dipsy::configure(DIPSY_CRESETB, DIPSY_CDONE, DIPSY_SS, SPI, dipsyConfig))
  {
    Serial.println("done");
    Serial.flush();
  }
  else
  {
    Serial.println("error");
    Serial.flush();
    while(1);
  }
  SPI.end();
  pinMode(MY_PIN, OUTPUT);
}

void loop() {
  // put your main code here, to run repeatedly:
  digitalWriteFast(MY_PIN, !digitalReadFast(MY_PIN));
  delay(500);
}
