AnttiLukats/DIPSY/THP2015/examples/verilog/spi_peripherals/01_pwm_led/sketch/bitmap.cpp

#include <stddef.h>
#include <stdint.h>

extern const uint8_t bitmap[] = {
0xff,0x00,0x4c,0x61,0x74,0x74,0x69,0x63,0x65,0x00,0x69,0x43,0x45,0x63,0x75,0x62,0x65,0x32,0x20,0x32,0x30,0x31,0x35,0x2e,0x30,0x34,0x2e,0x32,0x37,0x34,0x30,0x39,0x00
,0x50,0x61,0x72,0x74,0x3a,0x20,0x69,0x43,0x45,0x34,0x30,0x55,0x4c,0x31,0x4b,0x2d,0x53,0x57,0x47,0x31,0x36,0x00,0x44,0x61,0x74,0x65,0x3a,0x20,0x53,0x65,0x70,0x20
,0x32,0x30,0x20,0x32,0x30,0x31,0x35,0x20,0x32,0x32,0x3a,0x33,0x31,0x3a,0x32,0x36,0x00,0x00,0xff,0x7e,0xaa,0x99,0x7e,0x51,0x00,0x01,0x05,0x92,0x00,0x20,0x62,0x01
,0x6f,0x82,0x00,0x00,0x72,0x00,0x70,0x11,0x00,0x01,0x01,0x00,0x00,0x00,0x00,0x00,0x00,0x00,0x00,0x00,0x00,0x00,0x10,0x00,0x00,0x00,0x00,0x00,0x00,0x40,0x00,0x00
,0x00,0x00,0x00,0x01,0x00,0x00,0x00,0x00,0x00,0x40,0x00,0x00,0x00,0x00,0x00,0x01,0x00,0x00,0x00,0x00,0x00,0x00,0x04,0x00,0x00,0x00,0x00,0x00,0x00,0x00,0x00,0x00
,0x00,0x00,0x00,0x00,0x20,0x00,0x00,0x00,0x00,0x00,0x00,0x80,0x00,0x00,0x00,0x00,0x00,0x02,0x00,0x00,0x00,0x00,0x00,0x80,0x00,0x00,0x00,0x00,0x00,0x02,0x00,0x00
,0x00,0x00,0x00,0x00,0x08,0x00,0x00,0x00,0x00,0x00,0x00,0x00,0x00,0x00,0x00,0x00,0x00,0x00,0x00,0x00,0x00,0x00,0x00,0x00,0x00,0x00,0x00,0x00,0x00,0x00,0x00,0x00
,0x00,0x00,0x00,0x00,0x00,0x00,0x00,0x00,0x00,0x00,0x00,0x00,0x00,0x00,0x00,0x00,0x00,0x00,0x00,0x00,0x00,0x00,0x00,0x00,0x00,0x00,0x00,0x00,0x00,0x00,0x00,0x00
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
,0x00,0x00,0x00,0x0c,0x30,0x20,0x00,0x00,0x00,0x00,0x00,0x00,0x00,0x00,0x00,0x00,0x00,0x00,0x00,0x00,0x00,0x00,0x00,0x00,0x00,0x00,0x00,0x00,0x00,0xa5,0x40,0x00
,0x00,0x80,0x01,0x33,0xd4,0x00,0x00,0x02,0x60,0x15,0xbb,0x14,0x00,0x00,0x00,0x00,0x00,0x0c,0x30,0x00,0x00,0x00,0x00,0x00,0x00,0x00,0x00,0x00,0x00,0x00,0x00,0x00
,0x00,0x00,0x00,0x00,0x00,0x00,0x00,0x00,0x34,0x01,0x40,0x5a,0x00,0x00,0x08,0x10,0x03,0x43,0xfc,0x00,0x00,0x00,0x40,0x02,0x8b,0x10,0x00,0x00,0x00,0x00,0x00,0x0c
,0x30,0x20,0x00,0x00,0x00,0x00,0x00,0x00,0x00,0x00,0x00,0x00,0x00,0x00,0x00,0x00,0x00,0x00,0x00,0x00,0x00,0x00,0x36,0x00,0x18,0xf0,0x40,0x00,0x00,0x18,0x1b,0xf9
,0xd0,0x08,0x00,0x00,0x00,0x17,0x8a,0x54,0x00,0x00,0x00,0x00,0x00,0x0c,0x30,0x00,0x00,0x00,0x00,0x00,0x00,0x00,0x00,0x00,0x00,0x00,0x00,0x00,0x00,0x00,0x00,0x00
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
extern const size_t bitmap_size=30942;
