AnttiLukats/DIPSY/(commit log)

2015-08-17 Hardware design initial commit
    Altium Designer 14.3, Project, Schematic,, PCB, Outljob, output files,
    PDF, Gerber NCDrill, BOM, Step
    [BOM-DIPSY-01.csv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]
2015-09-12 Fritzing initial designs
    [DIPSY_CONFIG.fzz, DIPSY_EDISON.fzz, DIPSY_Galileo.fzz, DIPSY_RPi_modela.fzz]
2015-09-13 fritzing sketch with propeller
    [DIPSY_Propeller.fzz]
2015-09-13 volunteer made lib for KiCAD
2015-09-14 place holder for spi peripheral examples
2015-09-17 added basics/01_inout example: demonstrates use of LED driver pins as user I/O
2015-09-17 improved circuit description
2015-09-18 PCB top image
2015-09-18 added WS2812B example: - standalone - single pixel - fixed color
    [WS2812B_cr_v0_1.v, sketch.ino, top.v, ws2812_cr_single_fixed.cpp]
2015-09-20 dipsy easy PCB REV02
    [BOM-DIPSY-01.csv, BOM-DIPSY-02.csv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]
2015-09-20 Added tools for configuring DIPSY either using Raspberry PI, Beaglebone or Intel Edison.
2015-09-20 Fixed 02_blinky readme added blinky with hfosc and rgb driver
    [bitmap.cpp, clockdivider.v, sketch.ino, top.v]
2015-09-20 added another blinky using the low frequency oscillator
    [bitmap.cpp, clockdivider.v, sketch.ino, top.v]
2015-09-20 Added PWM SPI slave example
2015-09-21 release for finals
    [Arduino-Headers.SchDoc, BOM-TE0888-02.csv, DIPSY_UL1K16_LED5.PcbDoc, DIPSY_UL1K16_LED5.PrjPCB, DIPSY_UL1K16_LED5.SchDoc, FTDI.SchDoc, ICE.SchDoc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]
2015-10-03 DIPSY-STARTER
    1x1 Inch base board first commit
    [TE7300.PcbDoc, TE7300.PrjPCB, TE7300.SchDoc]
